rifotu/uradmonitor_d/readme.txt

Portable Environmental Monitor
(C) 2015 Radu Motisan , radu.motisan@gmail.com

Released under lGPL v3.

http://www.pocketmagic.net/portable-environmental-monitor/
