rifotu/uradmonitor_d/pcb/100/example/readme.txt

The cyan area must be milled out. The gerber files also indicate the milling layer.
