rifotu/uradmonitor_d/pcb/100/example/sample_pcb_bottom.png

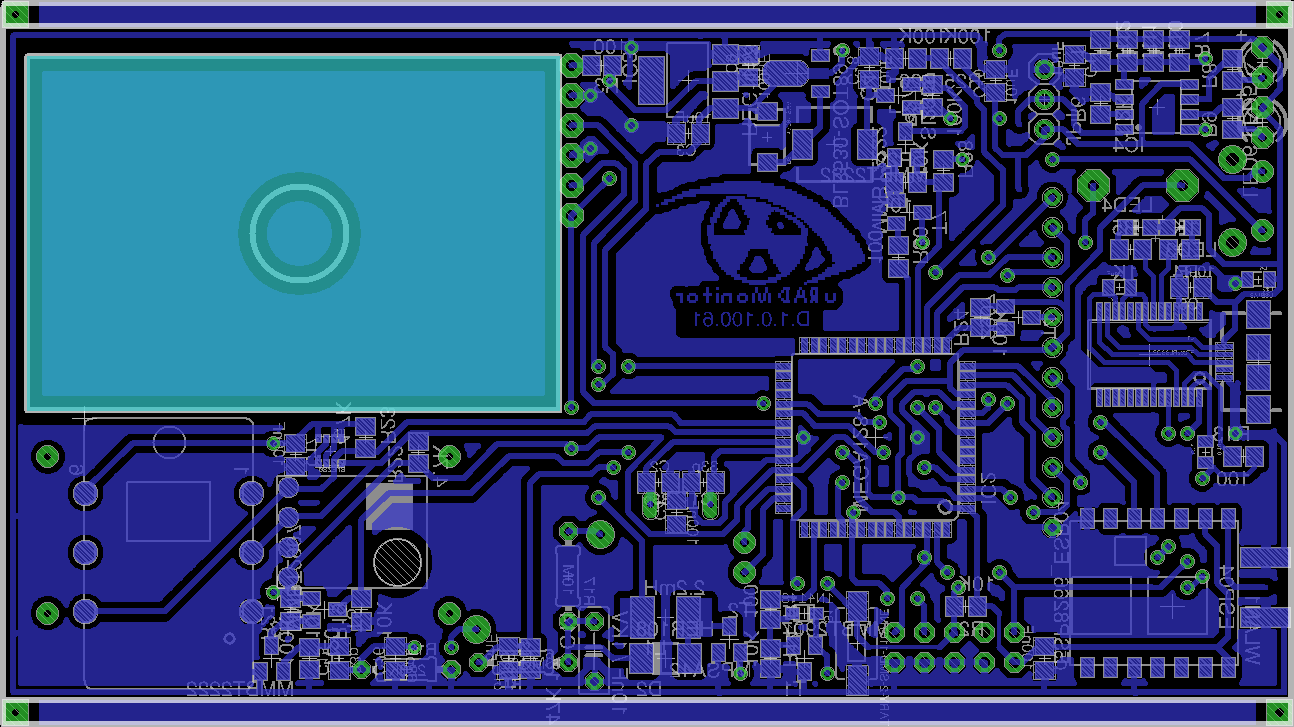
pcb/100/example/sample_pcb_bottom.png
