rifotu/uradmonitor_d/pcb/100/example/sample_pcb_top.png

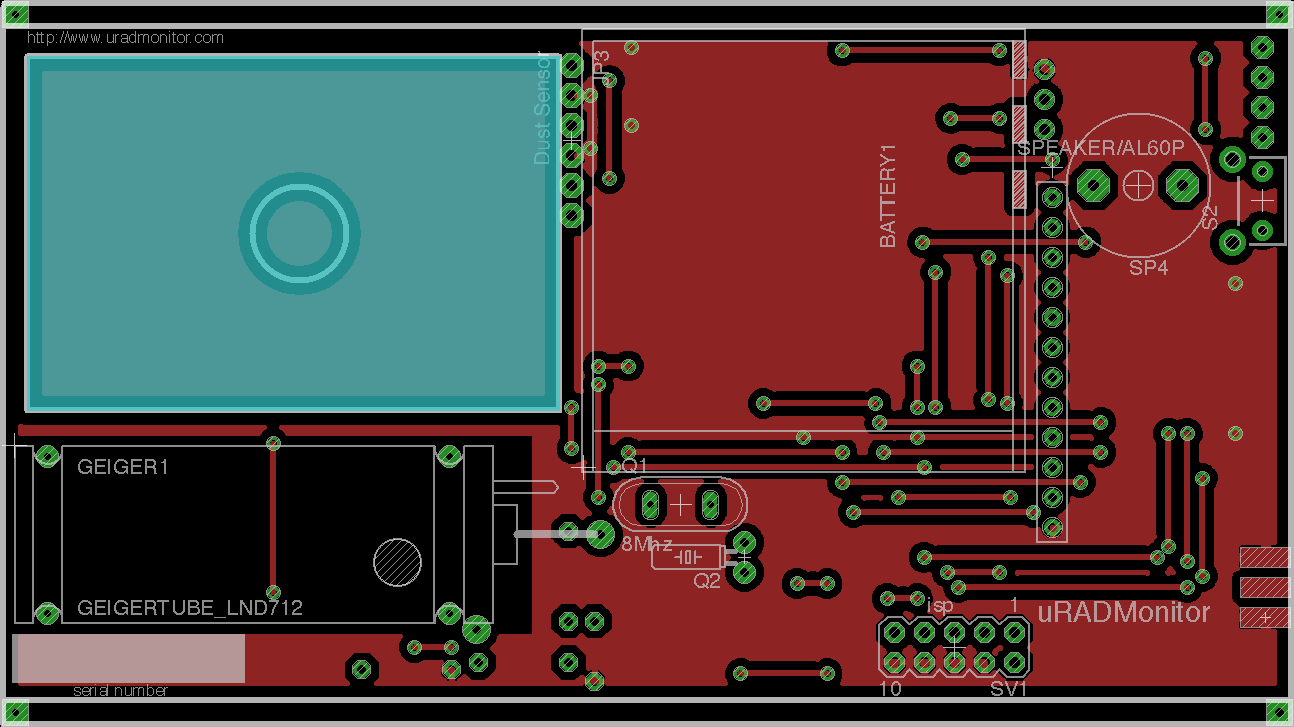
pcb/100/example/sample_pcb_top.png
