rifotu/uradmonitor_d/pcb/101/milling/cutout.png

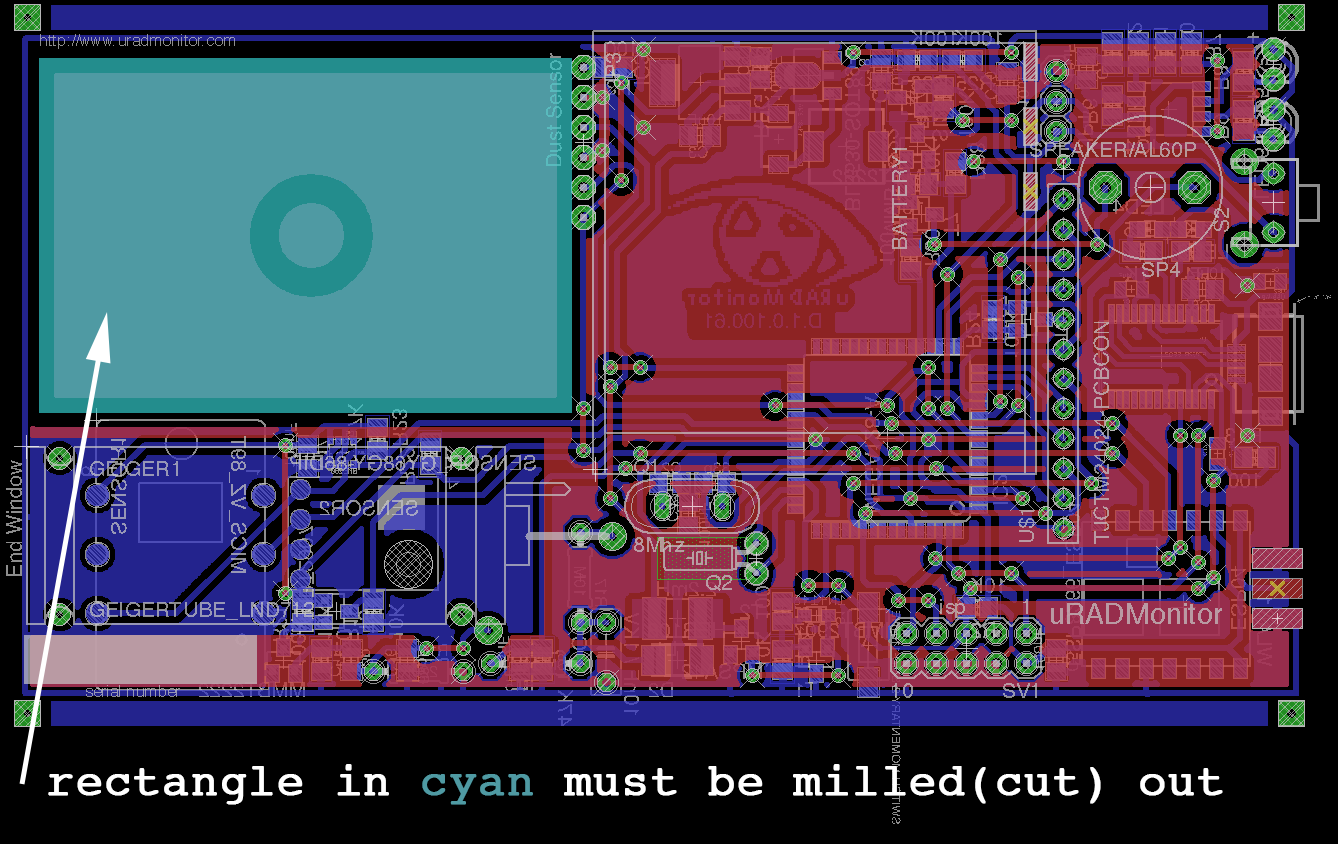
pcb/101/milling/cutout.png
