rifotu/uradmonitor_d/pcb/101/milling/milling_start.png

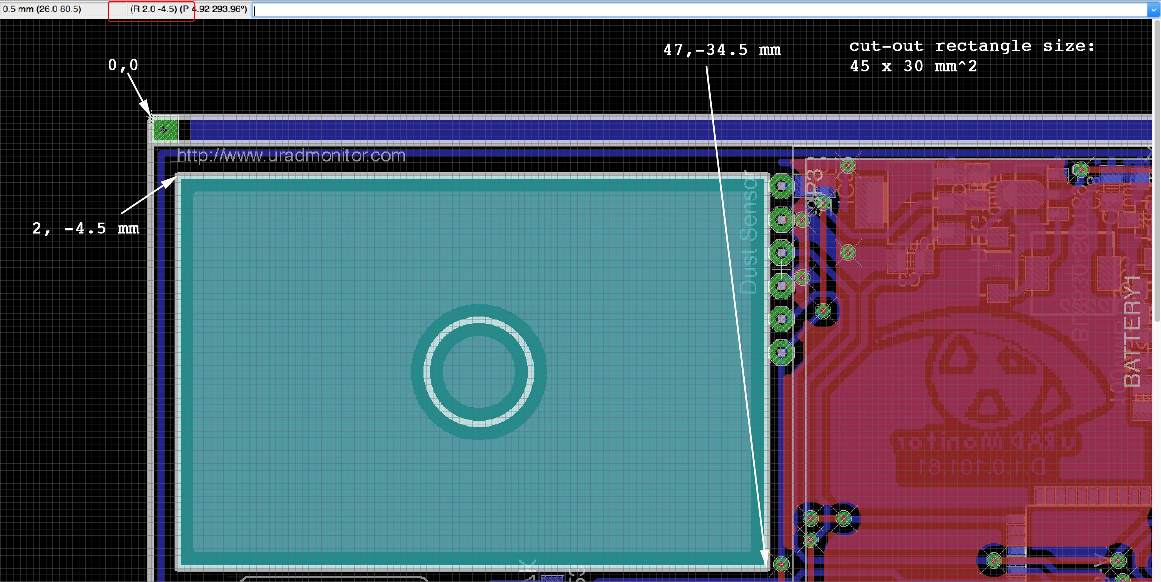
pcb/101/milling/milling_start.png
