rifotu/uradmonitor_d/(list of files, cad)

Other CAD files:
enclosure/100/uradmonitor_D_1110_box.dwg
enclosure/101/uradmonitor_D_1110_box_2007.dwg
enclosure/102/uradmonitor_D_1110_box_v102.dwg
enclosure/103/3d/uradmonitor_D_1110.dwg
enclosure/104/uradmonitor_D_1110.dwg
enclosure/105/uradmonitor_D_1110.dwg
enclosure/106/uradmonitor_D_1110.dwg
enclosure/107/AEH/AEH119.dwg
enclosure/107/uradmonitor_D_1110.dwg
enclosure/101/uradmonitor_D_1110_box.dwg
enclosure/102/uradmonitor_D_1110_box.dwg
enclosure/103/uradmonitor_D_1110.dwg
