rifotu/uradmonitor_d/enclosure/102/uradmonitor_D_1110_box.pdf

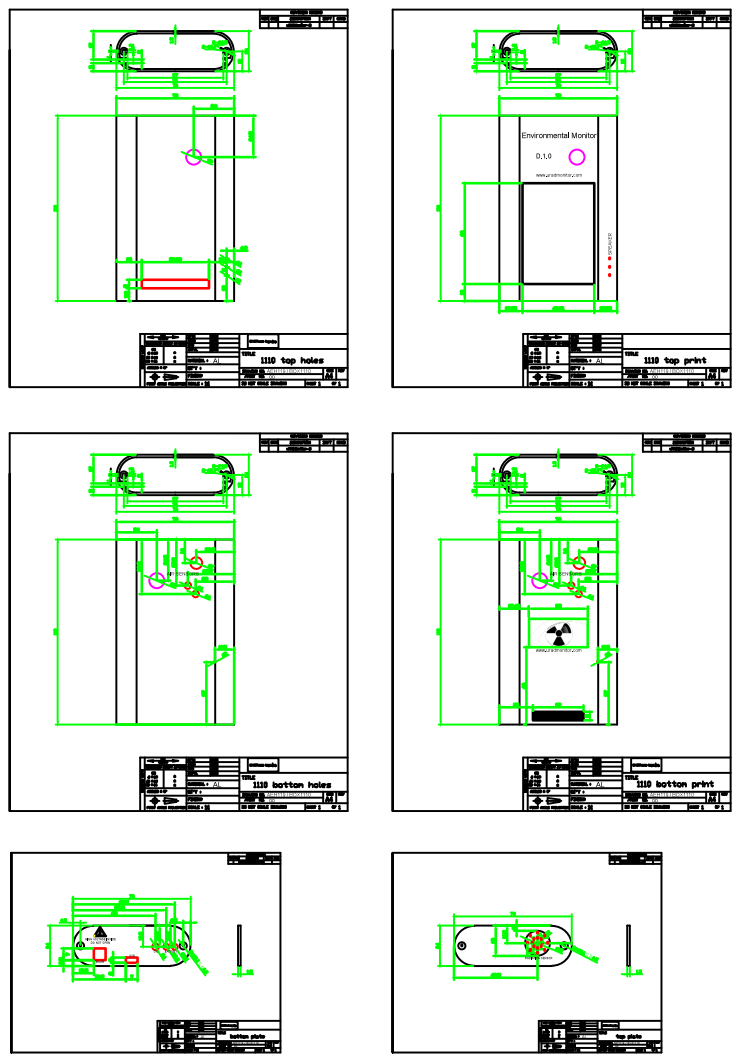
[picture p5: page 1]
