rifotu/uradmonitor_d/enclosure/107/AEH/AEH119.pdf

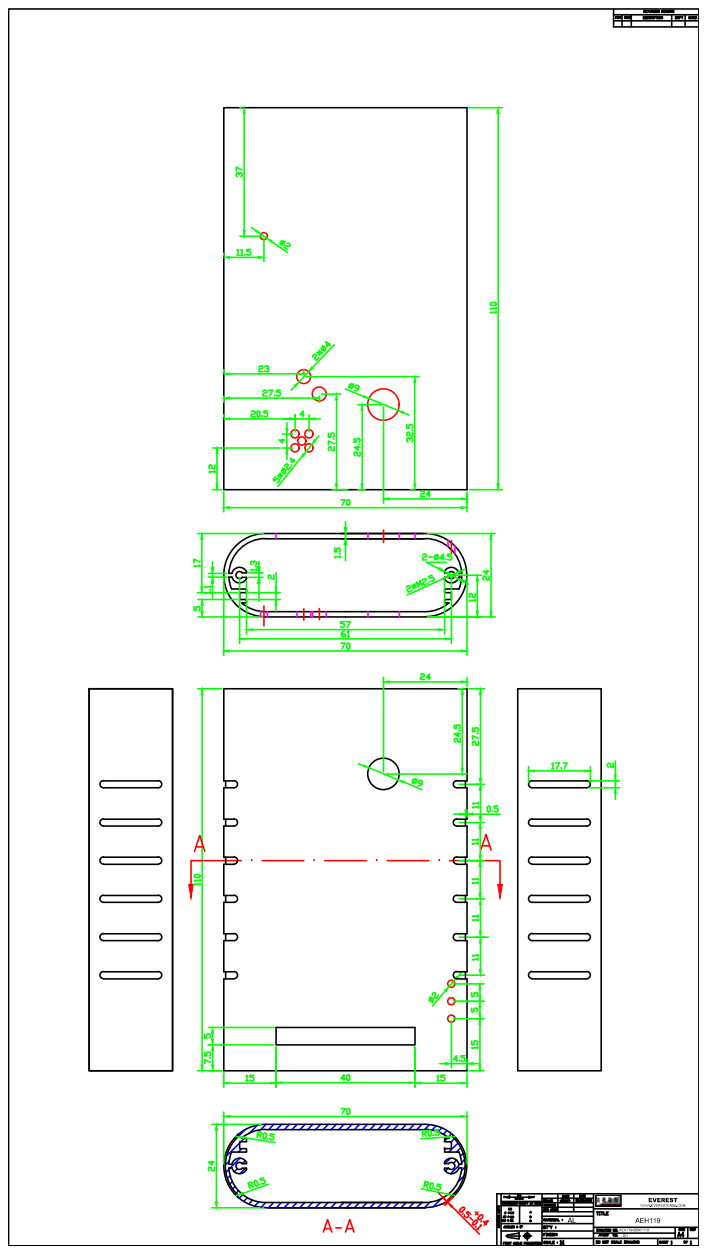
[picture p6: page 1]

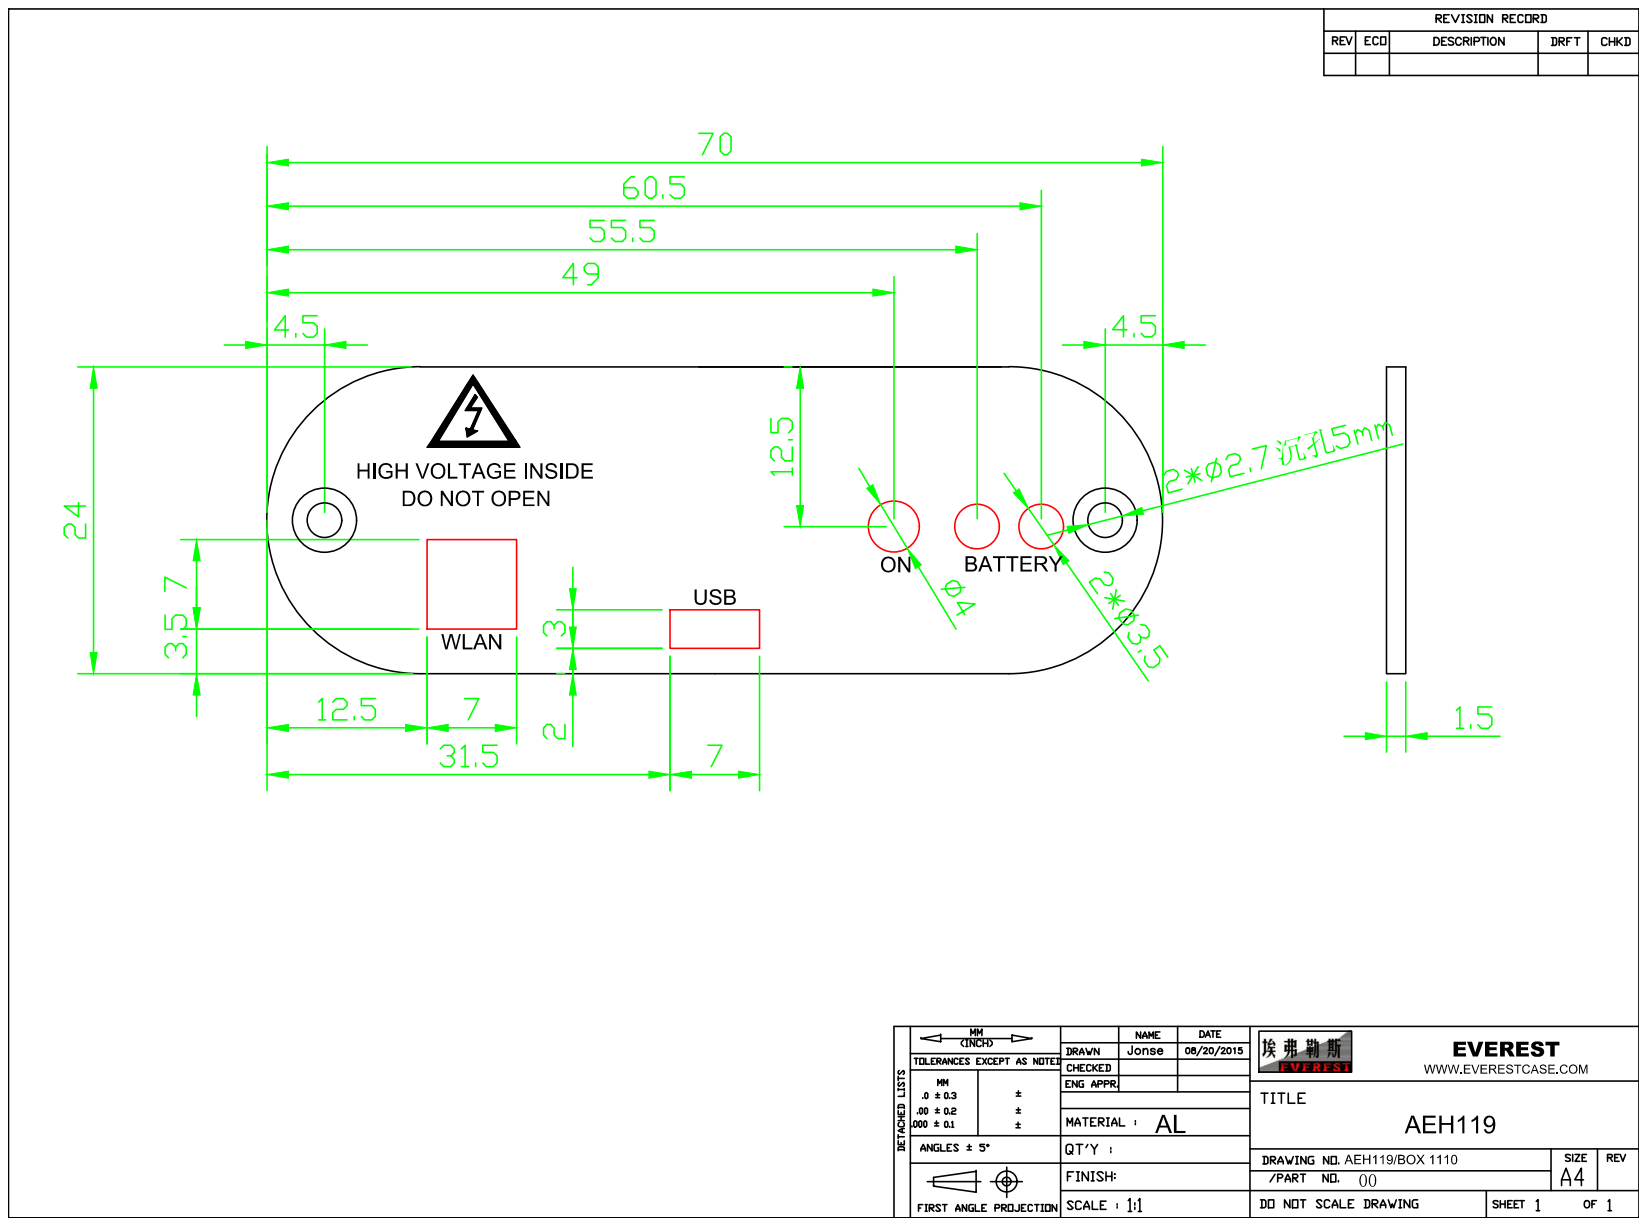
[picture p7: page 2]

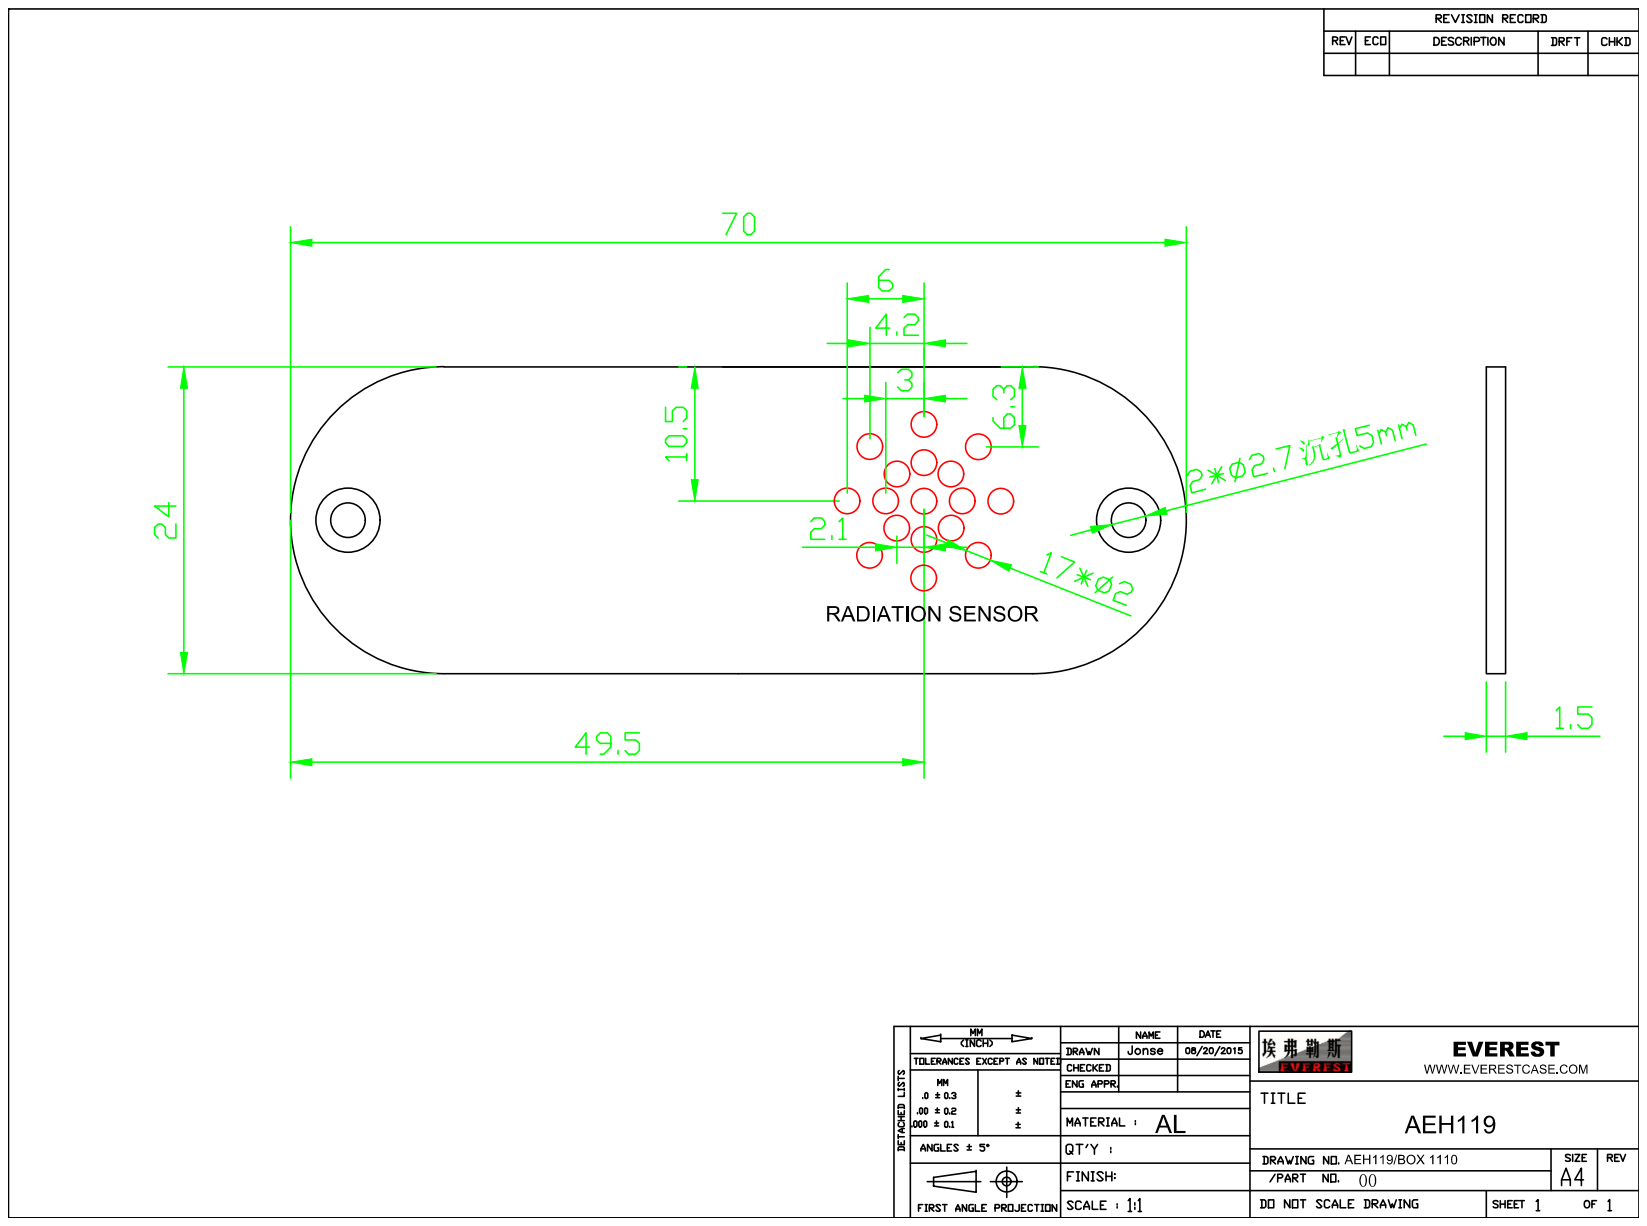
[picture p8: page 3]
