rifotu/uradmonitor_d/enclosure/103/3d/uradmonitor_D_1110.pdf

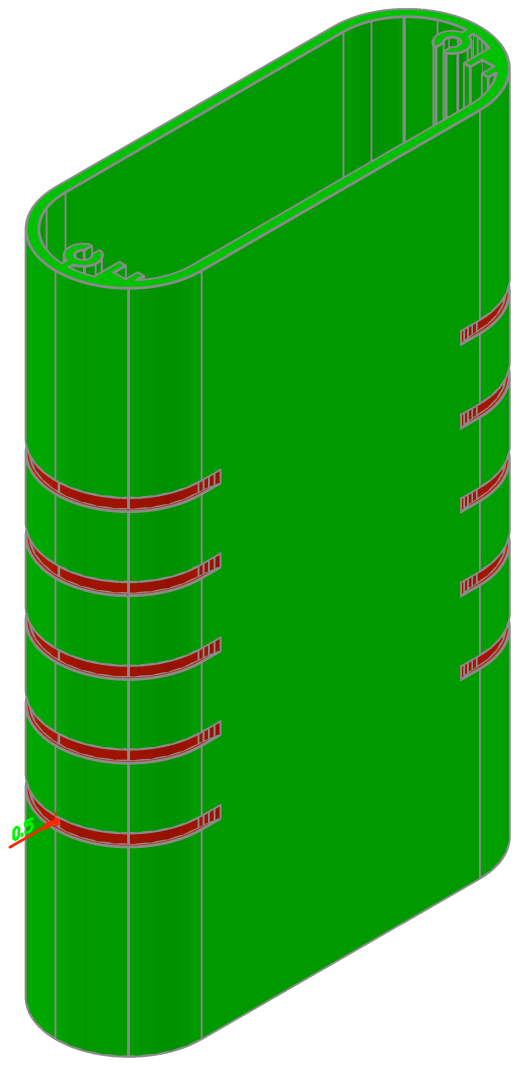
[picture p9: page 1]
