rifotu/uradmonitor_d/pcb/102/uradmonitor_D.brd

## EAGLE design pcb/102/uradmonitor_D.brd (2015-09-18)

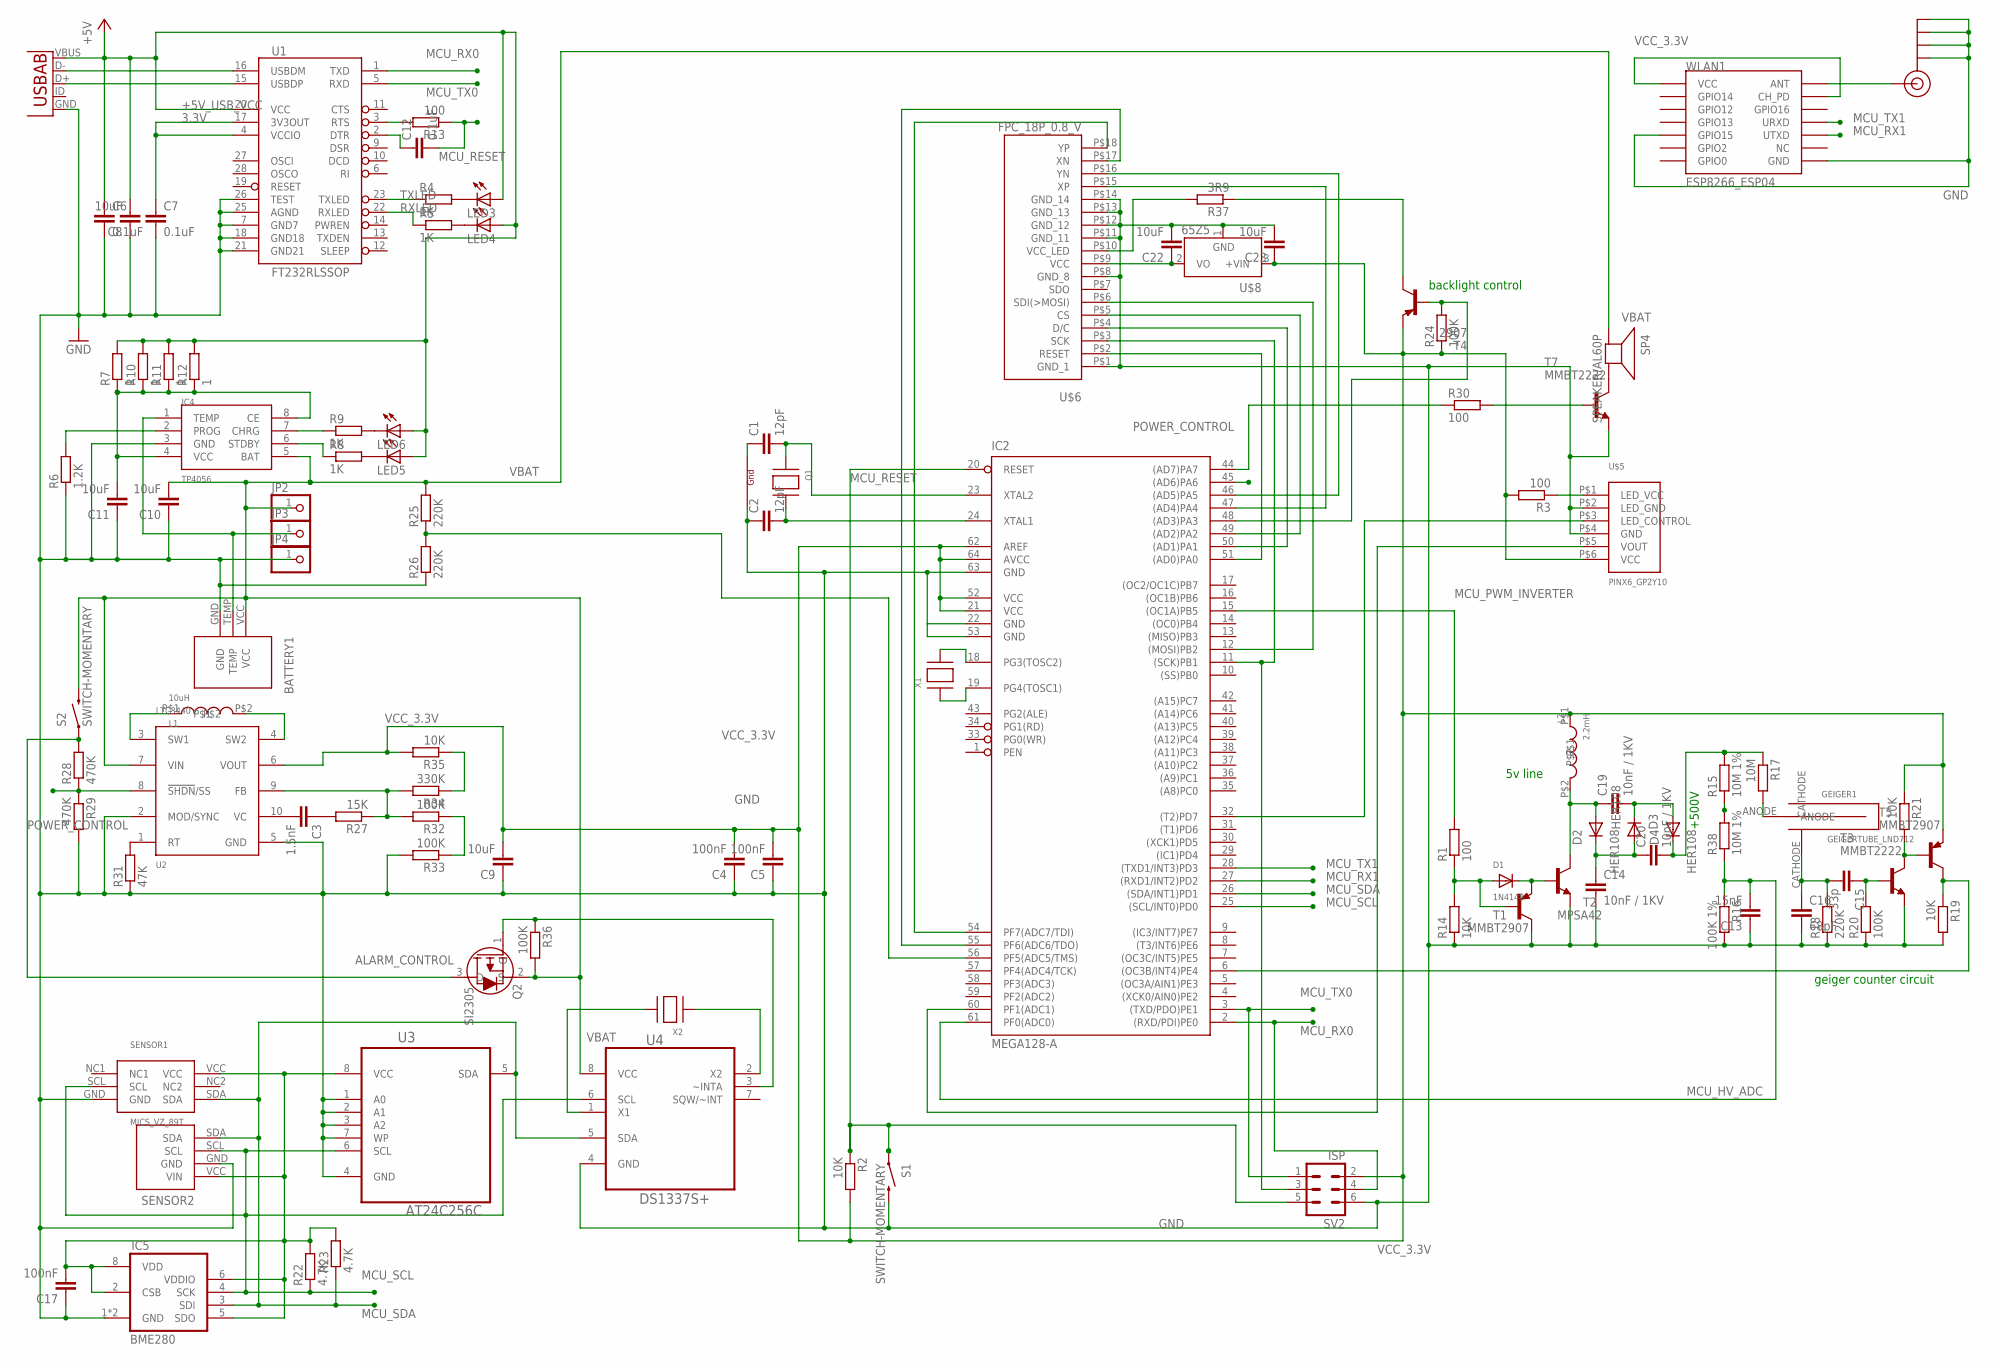
[picture p10: schematic uradmonitor_D.sch]

Parts:
BATTERY1: BAT-CASIO-NP40BATTERY; BAT-CASIO-NP40
C1, C2: 12pF; C0805K
C3: 1.5nF; C0805K
C4, C5, C17: 100nF; C0805K
C6, C7, C12: 0.1uF; 0805
C8, C9, C10, C11: 10uF; C0805K
C13: 15nF; C0805K
C14, C19, C20: 10nF / 1KV; C1206K
C15: 33p; C0805K
C16: 68pF; C0805K
C22, C23: 10uF; C0805
D1: 1N4148; SOD-323F
D2, D3, D4: HER108; DO-214AC
GEIGER1: GEIGERTUBE_LND712
IC2: MEGA128-A; TQFP64
IC4: TP4056
IC5: BME280
J$1: SMA_EDGE; SMA-EDGE
JP2, JP3, JP4: PINHD-1X1CB; 1X01-CLEANBIG
L1: 10uH; DO1608
L2: 2.2mH; DO1608
LED3, LED4: LEDCHIP-LED0805; CHIP-LED0805
LED5, LED6: LED3MM
Q1: XTAL-4-3225; NX3225
Q2: SI2305; SOT23
R1, R3, R13, R30: 100; R0805
R2, R14, R19, R21, R35: 10K; R0805
R4, R5, R8, R9: 1K; R0805
R6: 1.2K; R0805
R7, R10, R11, R12: 1; R0805
R15, R38: 10M 1%; 0204/7
R16: 100K 1%; R0805
R17: 10M; 0204/7
R18: 220K; 0204/7
R20, R24, R32, R33, R36: 100K; R0805
R22, R23: 4.7K; R0805
R25, R26: 220K; R0805
R27: 15K; R0805
R28, R29: 470K; R0805
R31: 47K; R0805
R34: 330K; R0805
R37: 3R9; R0805
S1: SWITCH-MOMENTARY; TACTILE-SWITCH-1101NE
S2: SWITCH-MOMENTARY; TACTILE-PTH-SIDEEZ
SENSOR1: MICS_VZ_89T
SENSOR2: BMP180; SENSOR_GY68
SP4: SPEAKER/AL60P; AL60P
SV2: ISP; MA03-2
T1, T5: MMBT2907; SOT23-BEC
T2: MPSA42; SOT23-BEC
T3, T7: MMBT2222; SOT23-BEC
T4: 2907; SOT23-BEC
U1: FT232RLSSOP; SSOP28DB
U2: LTC3440; MSOP-10
U3: AT24C256C; SOIC127P600X175-8N
U4: DS1337S+; SOIC127P600X175-8N
U$2: USB_AB; USB-AB-MICRO-SMD
U$5: PINX6_GP2Y10
U$6: FPC_18P_0.8_V
U$8: 65Z5; SOT23
WLAN1: ESP8266_ESP04
X1, X2: XTAL-3.2X1.5; XTAL3215

Connections:
3.3V: C7.1, U1.4 (VCCIO), U1.17 (3V3OUT)
+5V_USB_VCC: C6.1, C8.2, LED3.A, LED4.A, LED5.A, LED6.A, R7.2, R10.2, R11.2, R12.2, U1.20 (VCC), U$2.VBUS
ALARM_CONTROL: Q2.3 (D), R28.2, S2.1
GND: BATTERY1.GND, C2.1, C4.1, C5.1, C6.2, C7.2, C8.1, C9.1, C10.1, C11.1, C13.1, C14.2, C16.2, C17.1, C22.2, C23.2, IC2.22 (GND), IC2.53 (GND), IC2.63 (GND), IC4.3 (GND), IC5.1 (GND), IC5.7 (GND), J$1.GND@0 (GND), J$1.GND@1 (GND), J$1.GND@2 (GND), J$1.GND@3 (GND), JP4.1, Q1.2 (G2), R6.1, R14.1, R16.2, R18.1, R19.2, R20.1, R26.1, R29.2, R31.1, R33.2, S1.P$2 (2), SENSOR1.GND, SENSOR2.GND, SV2.6, T1.C, T2.E, T3.E, T7.E, U1.7 (GND7), U1.18 (GND18), U1.21 (GND21), U1.25 (AGND), U1.26 (TEST), U2.2 (MOD/SYNC), U2.5 (GND), U3.1 (A0), U3.2 (A1), U3.3 (A2), U3.4 (GND), U3.7 (WP), U4.4 (GND), U$2.GND, U$5.P$2 (LED_GND), U$5.P$4 (GND), U$6.P$1 (GND_1), U$6.P$8 (GND_8), U$6.P$11 (GND_11), U$6.P$12 (GND_12), U$6.P$13 (GND_13), U$6.P$14 (GND_14), U$8.1 (GND), WLAN1.GND, WLAN1.GPIO15
MCU_HV_ADC: C13.2, IC2.61 (PF0(ADC0)), R16.1, R38.1
MCU_INT4: IC2.6 ((OC3B/INT4)PE4), R19.1, T5.C
MCU_PWM_INVERTER: IC2.15 ((OC1A)PB5), R1.2
MCU_RESET: C12.2, IC2.20 (RESET), R2.1, R13.1, S1.P$1 (1), SV2.5
MCU_RX0: IC2.2 ((RXD/PDI)PE0), SV2.4, U1.1 (TXD)
MCU_RX1: IC2.27 ((RXD1/INT2)PD2), WLAN1.UTXD
MCU_SCL: IC2.25 ((SCL/INT0)PD0), IC5.4 (SCK), R22.1, SENSOR1.SCL, SENSOR2.SCL, U3.6 (SCL), U4.6 (SCL)
MCU_SDA: IC2.26 ((SDA/INT1)PD1), IC5.3 (SDI), R23.1, SENSOR1.SDA, SENSOR2.SDA, U3.5 (SDA), U4.5 (SDA)
MCU_TX0: IC2.3 ((TXD/PDO)PE1), SV2.1, U1.5 (RXD)
MCU_TX1: IC2.28 ((TXD1/INT3)PD3), WLAN1.URXD
unnamed: J$1.SIG (SIGNAL), WLAN1.ANT
unnamed: LED3.C, R4.2
unnamed: IC2.56 (PF5(ADC5/TMS)), R25.1, R26.2
unnamed: L1.P$2, U2.4 (SW2)
unnamed: R3.1, U$5.P$1 (LED_VCC)
unnamed: IC2.11 ((SCK)PB1), SV2.3, U$6.P$3 (SCK)
unnamed: LED4.C, R5.2
unnamed: D1.A, R1.1, R14.2, T1.B
unnamed: C1.2, IC2.23 (XTAL2), Q1.1 (X1)
unnamed: L1.P$1, U2.3 (SW1)
unnamed: C2.2, IC2.24 (XTAL1), Q1.3 (X2)
unnamed: IC2.18 (PG3(TOSC2)), X1.P$2
unnamed: R37.1, T4.C
unnamed: IC2.12 ((MOSI)PB2), U$6.P$6 (SDI(>MOSI))
unnamed: U1.16 (USBDM), U$2.D-
unnamed: U1.15 (USBDP), U$2.D+
unnamed: D1.C, T1.E, T2.B
unnamed: IC4.6 (STDBY), R8.1
unnamed: GEIGER1.ANODE, R17.2
unnamed: C15.1, R20.2, T3.B
unnamed: IC4.7 (CHRG), R9.1
unnamed: LED6.K (C), R9.2
unnamed: IC2.32 ((T2)PD7), U$5.P$3 (LED_CONTROL)
unnamed: LED5.K (C), R8.2
unnamed: C12.1, U1.2 (DTR)
unnamed: IC4.2 (PROG), R6.2
unnamed: R13.2, U1.3 (RTS)
unnamed: C11.2, IC4.4 (VCC), IC4.8 (CE), R7.1, R10.1, R11.1, R12.1
unnamed: IC2.19 (PG4(TOSC1)), X1.P$1
unnamed: BATTERY1.TEMP, IC4.1 (TEMP), JP3.1
unnamed: IC2.60 (PF1(ADC1)), U$5.P$5 (VOUT)
unnamed: IC2.44 ((AD7)PA7), R30.1
unnamed: R31.2, U2.1 (RT)
unnamed: C14.1, C20.1, D2.C, D3.A
unnamed: IC2.51 ((AD0)PA0), U$6.P$2 (RESET)
unnamed: C3.2, U2.10 (VC)
unnamed: IC2.50 ((AD1)PA1), U$6.P$4 (D/C)
unnamed: IC2.49 ((AD2)PA2), U$6.P$5 (CS)
unnamed: IC2.47 ((AD4)PA4), U$6.P$15 (XP)
unnamed: IC2.46 ((AD5)PA5), U$6.P$16 (YN)
unnamed: C15.2, C16.1, GEIGER1.CATHODE, R18.2
unnamed: IC2.54 (PF7(ADC7/TDI)), U$6.P$18 (YP)
unnamed: IC2.55 (PF6(ADC6/TDO)), U$6.P$17 (XN)
unnamed: IC2.48 ((AD3)PA3), R24.2, T4.B
unnamed: C3.1, R27.2
unnamed: R27.1, R32.2, R34.2, U2.9 (FB)
unnamed: R32.1, R33.1
unnamed: R34.1, R35.1
unnamed: C19.1, D2.A, L2.P$2, T2.C
unnamed: C22.1, U$6.P$9 (VCC), U$8.2 (VO)
unnamed: C19.2, D3.C, D4.A
unnamed: C20.2, D4.C, R15.2, R17.1
unnamed: U4.2 (X2), X2.P$1
unnamed: U4.1 (X1), X2.P$2
unnamed: R30.2, T7.B
unnamed: R21.2, T3.C, T5.B
unnamed: R15.1, R38.2
unnamed: Q2.1 (G), R36.1, U4.3 (~INTA)
unnamed: C1.1, Q1.4 (G1)
unnamed: R37.2, U$6.P$10 (VCC_LED)
POWER_CONTROL: IC2.45 ((AD6)PA6), R28.1, R29.1, U2.8 (!SHDN!/SS)
RXLED: R5.1, U1.22 (RXLED)
SOLDER_TUBE: SP4.2 (-), T7.C
TXLED: R4.1, U1.23 (TXLED)
VBAT: BATTERY1.VCC, C10.2, IC4.5 (BAT), JP2.1, Q2.2 (S), R25.2, R36.2, S2.2, SP4.1 (+), U2.7 (VIN), U4.8 (VCC)
VCC_3.3V: C4.2, C5.2, C9.2, C17.2, C23.1, IC2.21 (VCC), IC2.52 (VCC), IC2.62 (AREF), IC2.64 (AVCC), IC5.2 (CSB), IC5.5 (SDO), IC5.6 (VDDIO), IC5.8 (VDD), L2.P$1, R2.2, R3.2, R21.1, R22.2, R23.2, R24.1, R35.2, SENSOR1.VCC, SENSOR2.VCC (VIN), SV2.2, T4.E, T5.E, U2.6 (VOUT), U3.8 (VCC), U$5.P$6 (VCC), U$8.3 (+VIN), WLAN1.CH_PD, WLAN1.VCC

Notes on the sheet:
5v line
+500V
geiger counter circuit
backlight control

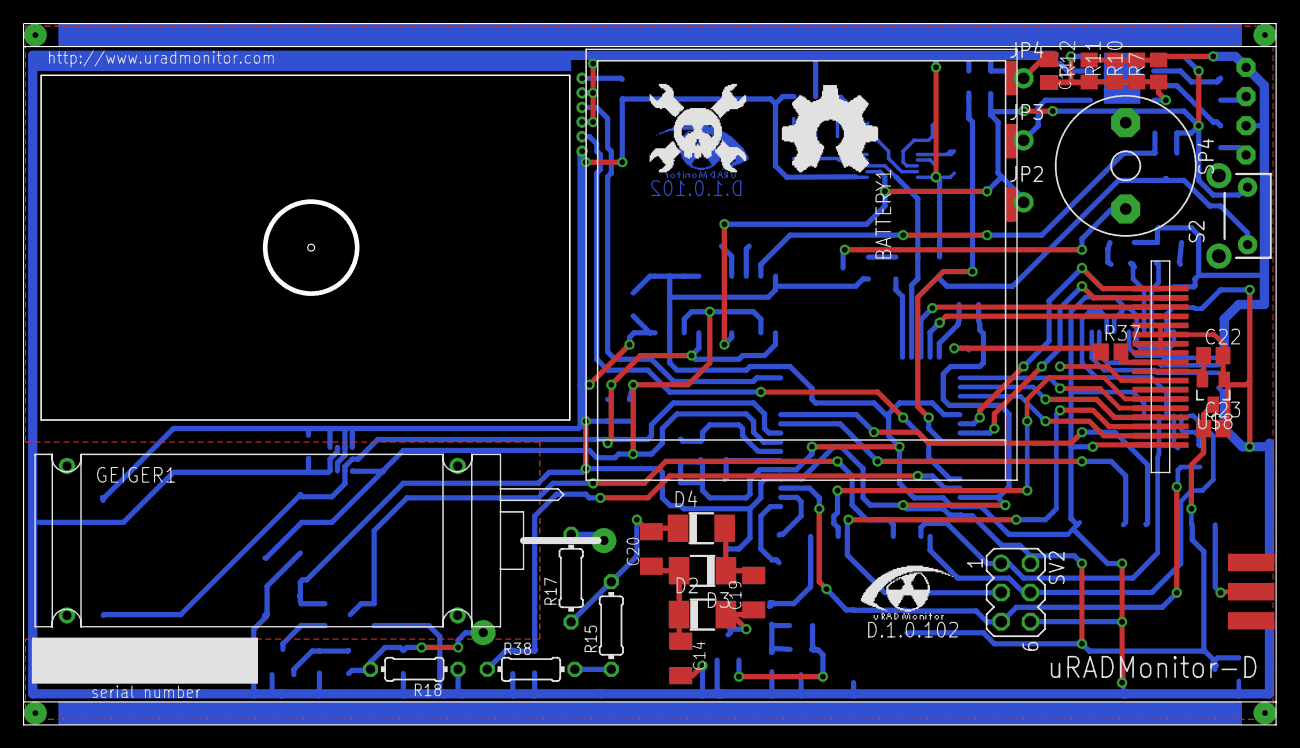
[picture p11: board uradmonitor_D.brd from above]

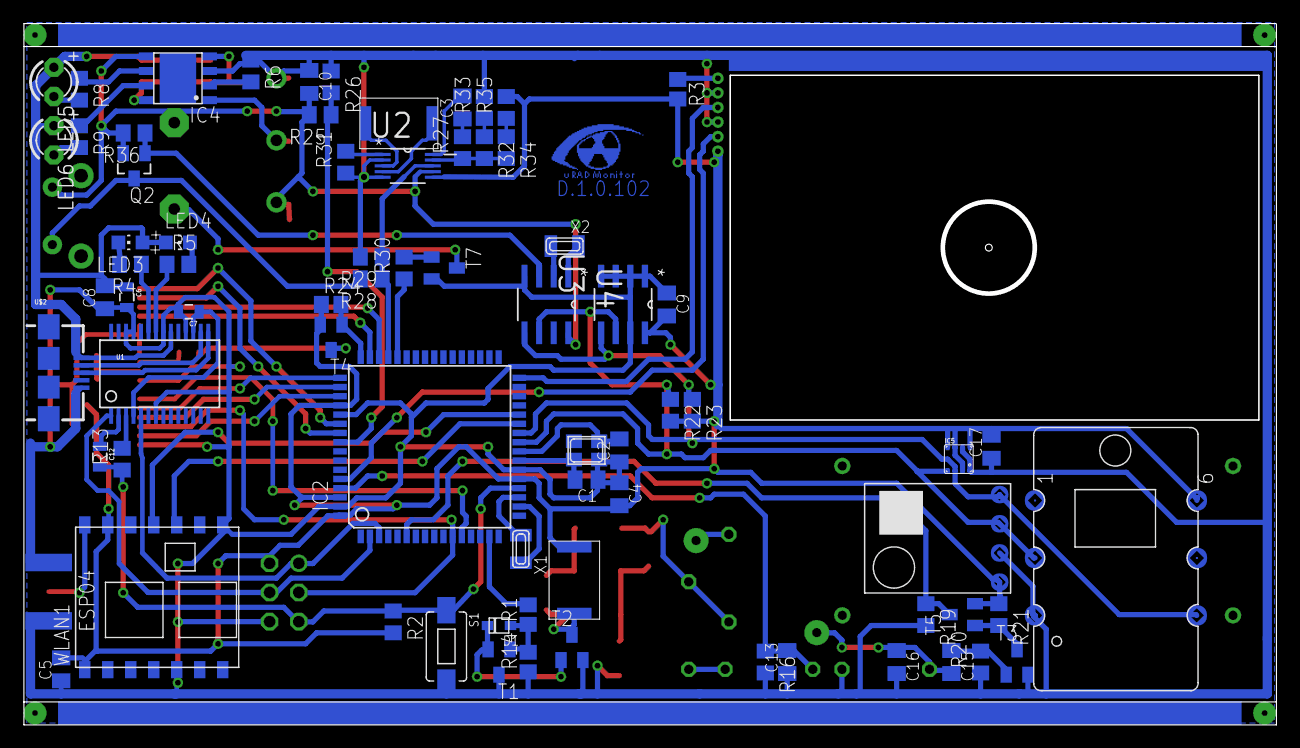
[picture p12: board uradmonitor_D.brd from below]

Board: 2 copper layers, 109.0 x 61.0 mm, 103 parts (73 on the bottom side), 80 nets.
