rifotu/uradmonitor_d/pcb/lcd_connector/lcdconnector1.brd

## EAGLE design pcb/lcd_connector/lcdconnector1.brd (2015-08-13)

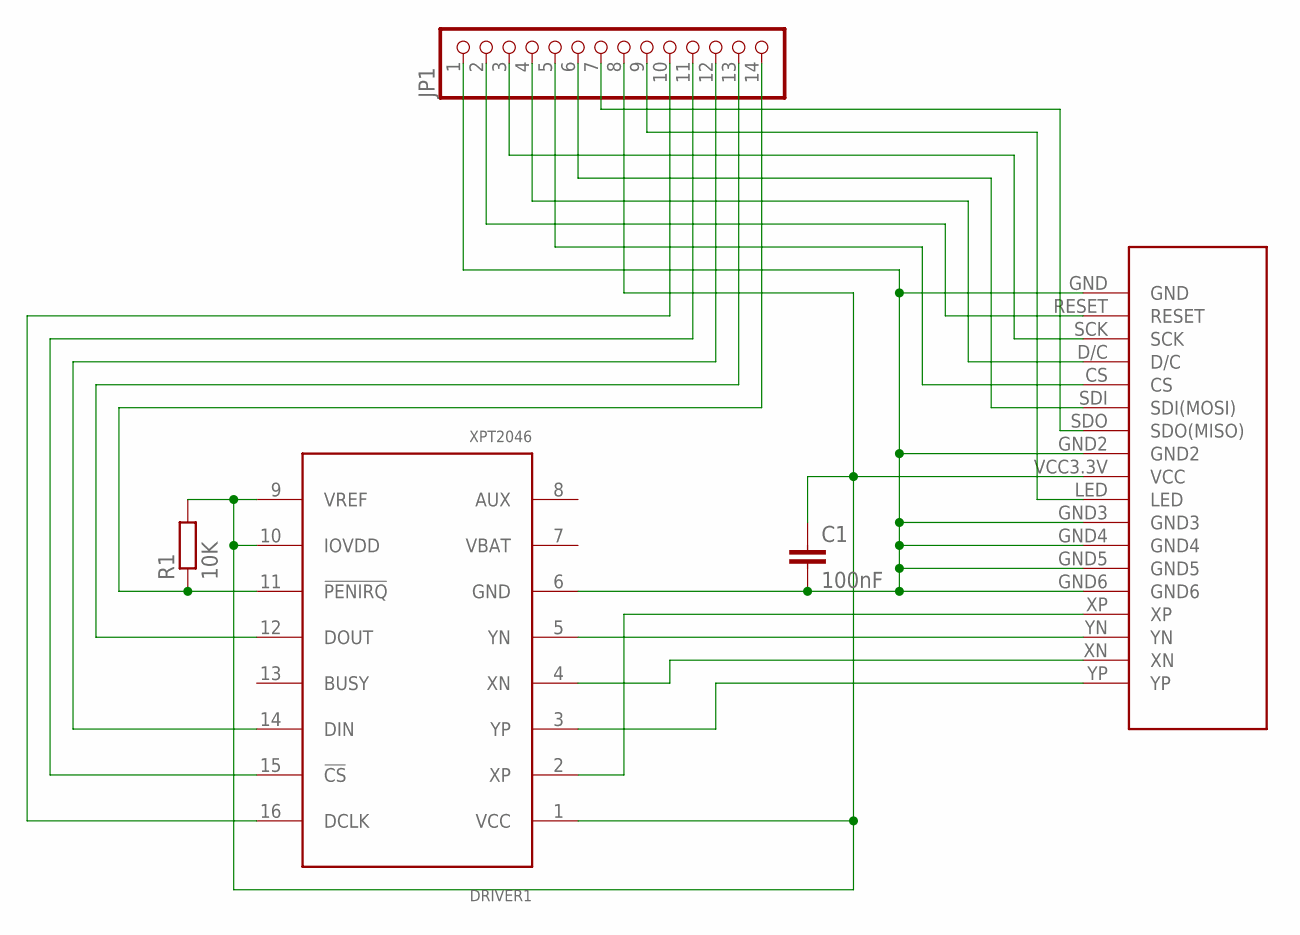
[picture p13: schematic lcdconnector1.sch]

Parts:
C1: 100nF; C0805K
CONNECTOR1: TJCTM24024-PINS
DRIVER1: XPT2046
JP1: PINHD-1X14-CB; 1X14-CB
R1: 10K; M0805

Connections:
unnamed: CONNECTOR1.XP, DRIVER1.2 (XP)
unnamed: CONNECTOR1.YP, DRIVER1.3 (YP)
unnamed: CONNECTOR1.XN, DRIVER1.4 (XN)
unnamed: CONNECTOR1.YN, DRIVER1.5 (YN)
unnamed: C1.2, CONNECTOR1.GND, CONNECTOR1.GND2, CONNECTOR1.GND3, CONNECTOR1.GND4, CONNECTOR1.GND5, CONNECTOR1.GND6, DRIVER1.6 (GND), JP1.1
unnamed: CONNECTOR1.CS, JP1.5
unnamed: CONNECTOR1.RESET, JP1.2
unnamed: CONNECTOR1.D/C, JP1.4
unnamed: CONNECTOR1.SDI (SDI(MOSI)), JP1.6
unnamed: CONNECTOR1.SCK, JP1.3
unnamed: CONNECTOR1.LED, JP1.9
unnamed: CONNECTOR1.SDO (SDO(MISO)), JP1.7
unnamed: DRIVER1.16 (DCLK), JP1.10
unnamed: DRIVER1.15 (!CS), JP1.11
unnamed: DRIVER1.14 (DIN), JP1.12
unnamed: DRIVER1.12 (DOUT), JP1.13
unnamed: DRIVER1.11 (!PENIRQ), JP1.14, R1.1
unnamed: C1.1, CONNECTOR1.VCC3.3V (VCC), DRIVER1.1 (VCC), DRIVER1.9 (VREF), DRIVER1.10 (IOVDD), JP1.8, R1.2

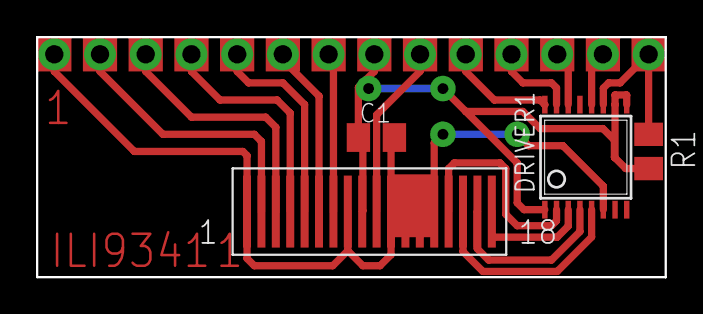
[picture p14: board lcdconnector1.brd from above]

Board: 2 copper layers, 34.9 x 13.3 mm, 5 parts (0 on the bottom side), 18 nets.
