rifotu/uradmonitor_d/pcb/lcd_connector/lcdconnector3.brd

## EAGLE design pcb/lcd_connector/lcdconnector3.brd (2015-08-13)

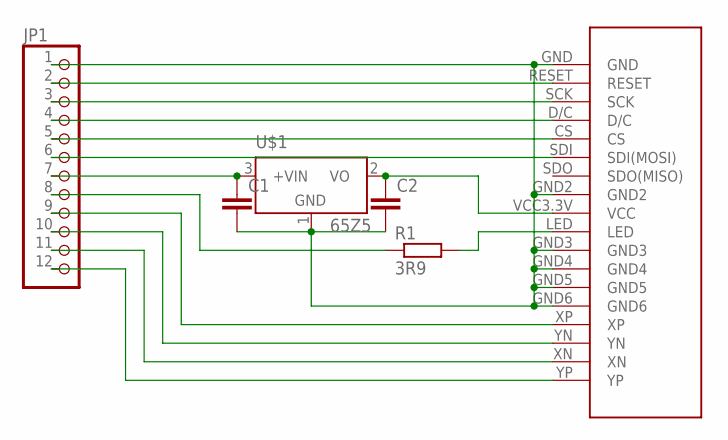
[picture p15: schematic lcdconnector3.sch]

Parts:
C1, C2: C-EUC0805; C0805
CONNECTOR1: TJCTM24024-PINS
JP1: PINHD-1X12-CB; 1X12-CB
R1: 3R9; R0805
U$1: 65Z5; SOT23

Connections:
unnamed: C1.2, C2.2, CONNECTOR1.GND, CONNECTOR1.GND2, CONNECTOR1.GND3, CONNECTOR1.GND4, CONNECTOR1.GND5, CONNECTOR1.GND6, JP1.1, U$1.1 (GND)
unnamed: CONNECTOR1.RESET, JP1.2
unnamed: CONNECTOR1.SCK, JP1.3
unnamed: CONNECTOR1.D/C, JP1.4
unnamed: CONNECTOR1.CS, JP1.5
unnamed: CONNECTOR1.SDI (SDI(MOSI)), JP1.6
unnamed: C1.1, JP1.7, U$1.3 (+VIN)
unnamed: C2.1, CONNECTOR1.VCC3.3V (VCC), U$1.2 (VO)
unnamed: CONNECTOR1.LED, R1.2
unnamed: JP1.8, R1.1
unnamed: CONNECTOR1.XP, JP1.9
unnamed: CONNECTOR1.YN, JP1.10
unnamed: CONNECTOR1.XN, JP1.11
unnamed: CONNECTOR1.YP, JP1.12

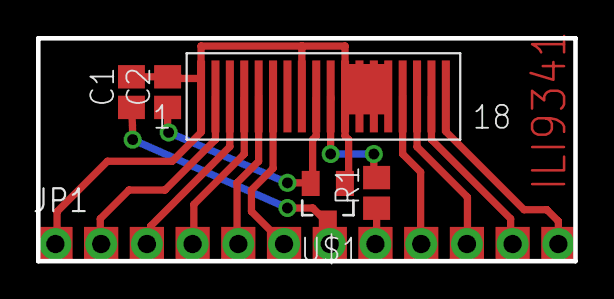
[picture p16: board lcdconnector3.brd from above]

Board: 2 copper layers, 29.8 x 12.4 mm, 6 parts (0 on the bottom side), 14 nets.
