rifotu/uradmonitor_d/code/100_beta/uart/uart.cpp

/*
** UART Library for AVR microcontrollers
** Copyright (C) 2009 - 2015 Radu Motisan, radu.motisan@gmail.com
** UART interrupt driven serial communication class file for atmega128
**
** www.pocketmagic.net
**
** This file is a part of "Portable Environmental Monitor" open source project presented on
** https://hackaday.io/project/4977-portable-environmental-monitor
**
** This project is free software; you can redistribute it and/or modify
** it under the terms of the GNU Lesser General Public License as published
** by the Free Software Foundation; either version 3 of the License,
** or (at your option) any later version.
**
** This program is distributed in the hope that it will be useful,
** but WITHOUT ANY WARRANTY; without even the implied warranty of
** MERCHANTABILITY or FITNESS FOR A PARTICULAR PURPOSE.  See the
** GNU Lesser General Public License for more details.
**
** You should have received a copy of the GNU Lesser General Public License
** along with this program. If not, see <http://www.gnu.org/licenses/>.
*/



#include "uart.h"
#include <stdio.h>
#include <string.h>


/*
 * To receive interrupt results, use:
 ISR(USART0_RX_vect){
	 volatile char c = UDR0; //Read the value out of the UART buffer
 }
 */

/*
 * AVR UART registers configured for Atmega128. For Atmega8 or others with a single UART interface, comment the XXX1 registers and flags (second line)
 */
#ifdef ATMEGA8
volatile uint8_t *uart_regs[2][6] = {
	{&UCSRA, &UCSRB, &UCSRC, &UDR, &UBRRH, &UBRRL}, // uart 0
	//{&UCSR1A, &UCSR1B, &UCSR1C, &UDR1, &UBRR1H, &UBRR1L}  // uart 1
};
uint8_t uart_flags[2][8] = {
	{ RXCIE, UDRE, RXC, RXEN, TXEN, UCSZ0, UCSZ1, TXC}, // uart 0
	//{ RXCIE1, UDRE1, RXC1, RXEN1, TXEN1, UCSZ10, UCSZ11, TXC1}  // uart 1
};
#endif

#ifdef ATMEGA128
volatile uint8_t *uart_regs[2][6] = {
	{&UCSR0A, &UCSR0B, &UCSR0C, &UDR0, &UBRR0H, &UBRR0L}, // uart 0
	{&UCSR1A, &UCSR1B, &UCSR1C, &UDR1, &UBRR1H, &UBRR1L}  // uart 1
};
uint8_t uart_flags[2][8] = {
	{ RXCIE0, UDRE0, RXC0, RXEN0, TXEN0, UCSZ00, UCSZ01, TXC0}, // uart 0
	{ RXCIE1, UDRE1, RXC1, RXEN1, TXEN1, UCSZ10, UCSZ11, TXC1}  // uart 1
};
#endif

/*
 * Initiates UART serial communication
 * uartindex: the UART index, for microcontrollers that have more than one (eg. atmega128 has too)
 * baud: an integer representing the baud rate
 * use_interrupt: receive data as interrupt, in ISR(USART0_RX_vect)/ISR(USART1_RX_vect) or by polling, using RecvPoll
 */
void UART::init(int uartindex, uint32_t baud, bool use_interrupt) {
	m_index = uartindex;
	// save baud
	m_nBaudRate = baud;
	m_index = uartindex;
	
	//Configure the UART registers
	//RXEN0 Reciever enabled
	//TXEN0 Transmit enabled
	*uart_regs[m_index][1] = (1 << uart_flags[m_index][3]) | (1 << uart_flags[m_index][4]);
	
	//UCSZ00 and UCSZ01 use 8 bit character size
	*uart_regs[m_index][2] = (1 << uart_flags[m_index][5]) | (1 << uart_flags[m_index][6]);

	//Set the baud rate
	m_nBaudRateRegister = F_CPU/16/baud-1;
	*uart_regs[m_index][4] = ((m_nBaudRateRegister >> 8) & 0x00FF);
	*uart_regs[m_index][5] = (m_nBaudRateRegister & 0x00FF);
	
	//RXCIE0 Enable interupt after receive
	// Set interrupts if required
	if (use_interrupt) {
		*uart_regs[m_index][1] |= (1<<uart_flags[m_index][0]);
		sei();
	}		
}

/*
 * send one byte, b
 */
void UART::send(uint8_t b) {
	// Wait until UDR ready
	while(!(*uart_regs[m_index][0] & (1 << uart_flags[m_index][1])));
	*uart_regs[m_index][3] = b;    // send character
}

/*
 * send a byte array (data) of given size (len)
 */
void UART::send(const unsigned char *data, int len) {
	if (len == -1) len = strlen((char *)data);
	// send bytes
	for (int i=0; i<len; i++) send(data[i]);
	// wait for complete transfer
	while (!(*uart_regs[m_index][0] & (1<<uart_flags[m_index][7])));
}

/*
 * send a formated string
 */
void UART::send(char *szFormat, ...) {
	char szBuffer[512]; //in this buffer we form the message
	int NUMCHARS = sizeof(szBuffer) / sizeof(szBuffer[0]);
	va_list pArgs;
	va_start(pArgs, szFormat);
	vsnprintf(szBuffer, NUMCHARS - 1, szFormat, pArgs);
	va_end(pArgs);
	
	send((const unsigned char *)szBuffer, -1);
}

/*
 * wait until one byte is received, and return: blocking function
 */
uint8_t UART::recvPoll() {
	// Wait until UDR ready
	while (!(*uart_regs[m_index][0]  & (1 << uart_flags[m_index][2]))) ;
	return *uart_regs[m_index][3];
}	
