rifotu/uradmonitor_d/(commit log)

2015-08-13 beta release
    [lcdconnector1.brd, lcdconnector1.sch, lcdconnector2.brd, lcdconnector2.sch, lcdconnector3.brd, lcdconnector3.sch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]
2015-08-13 added bom for current diagram
2015-08-16 added gitignore
    [uradmonitor_D_1110_box.dwg]
2015-08-19 enclosure v102
    [uradmonitor_D_1110_box.dwg, uradmonitor_D_1110_box_2007.dwg, uradmonitor_D_1110_box_v102.dwg]
2015-08-23 revision pcb 102. revision enclosure 103
    [uradmonitor_D.101.brd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]
2015-08-31 enclosure changes
    [AEH119.dwg, uradmonitor_D_1110.dwg]
2015-09-18 12pF caps to 16MHz crystal
    [uradmonitor_D.brd, uradmonitor_D.sch]
