rifotu/uradmonitor_d/(notices)

Notices in the files:
parts and their libraries:
sparkfun-connectors: Licensing: CC v3.0 Share-Alike You are welcome to use this library for commercial purposes.
